findersee/winchController/Electronics/controller.png

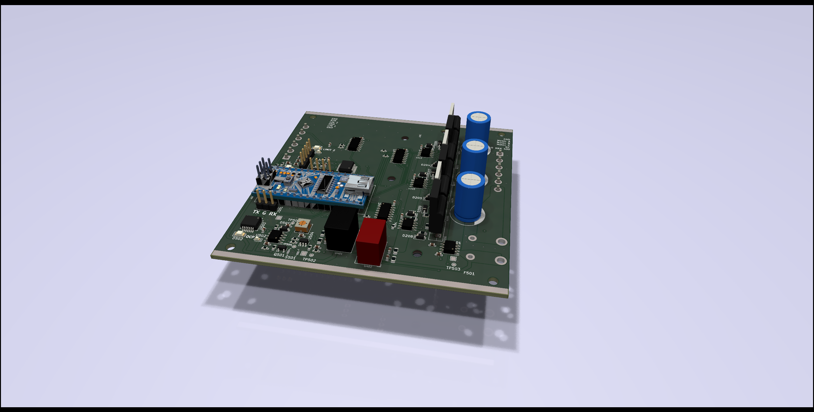
Electronics/controller.png
