findersee/winchController/Electronics/controller.kicad_pcb

## KiCad design Electronics/controller.kicad_pcb (2022-03-30)

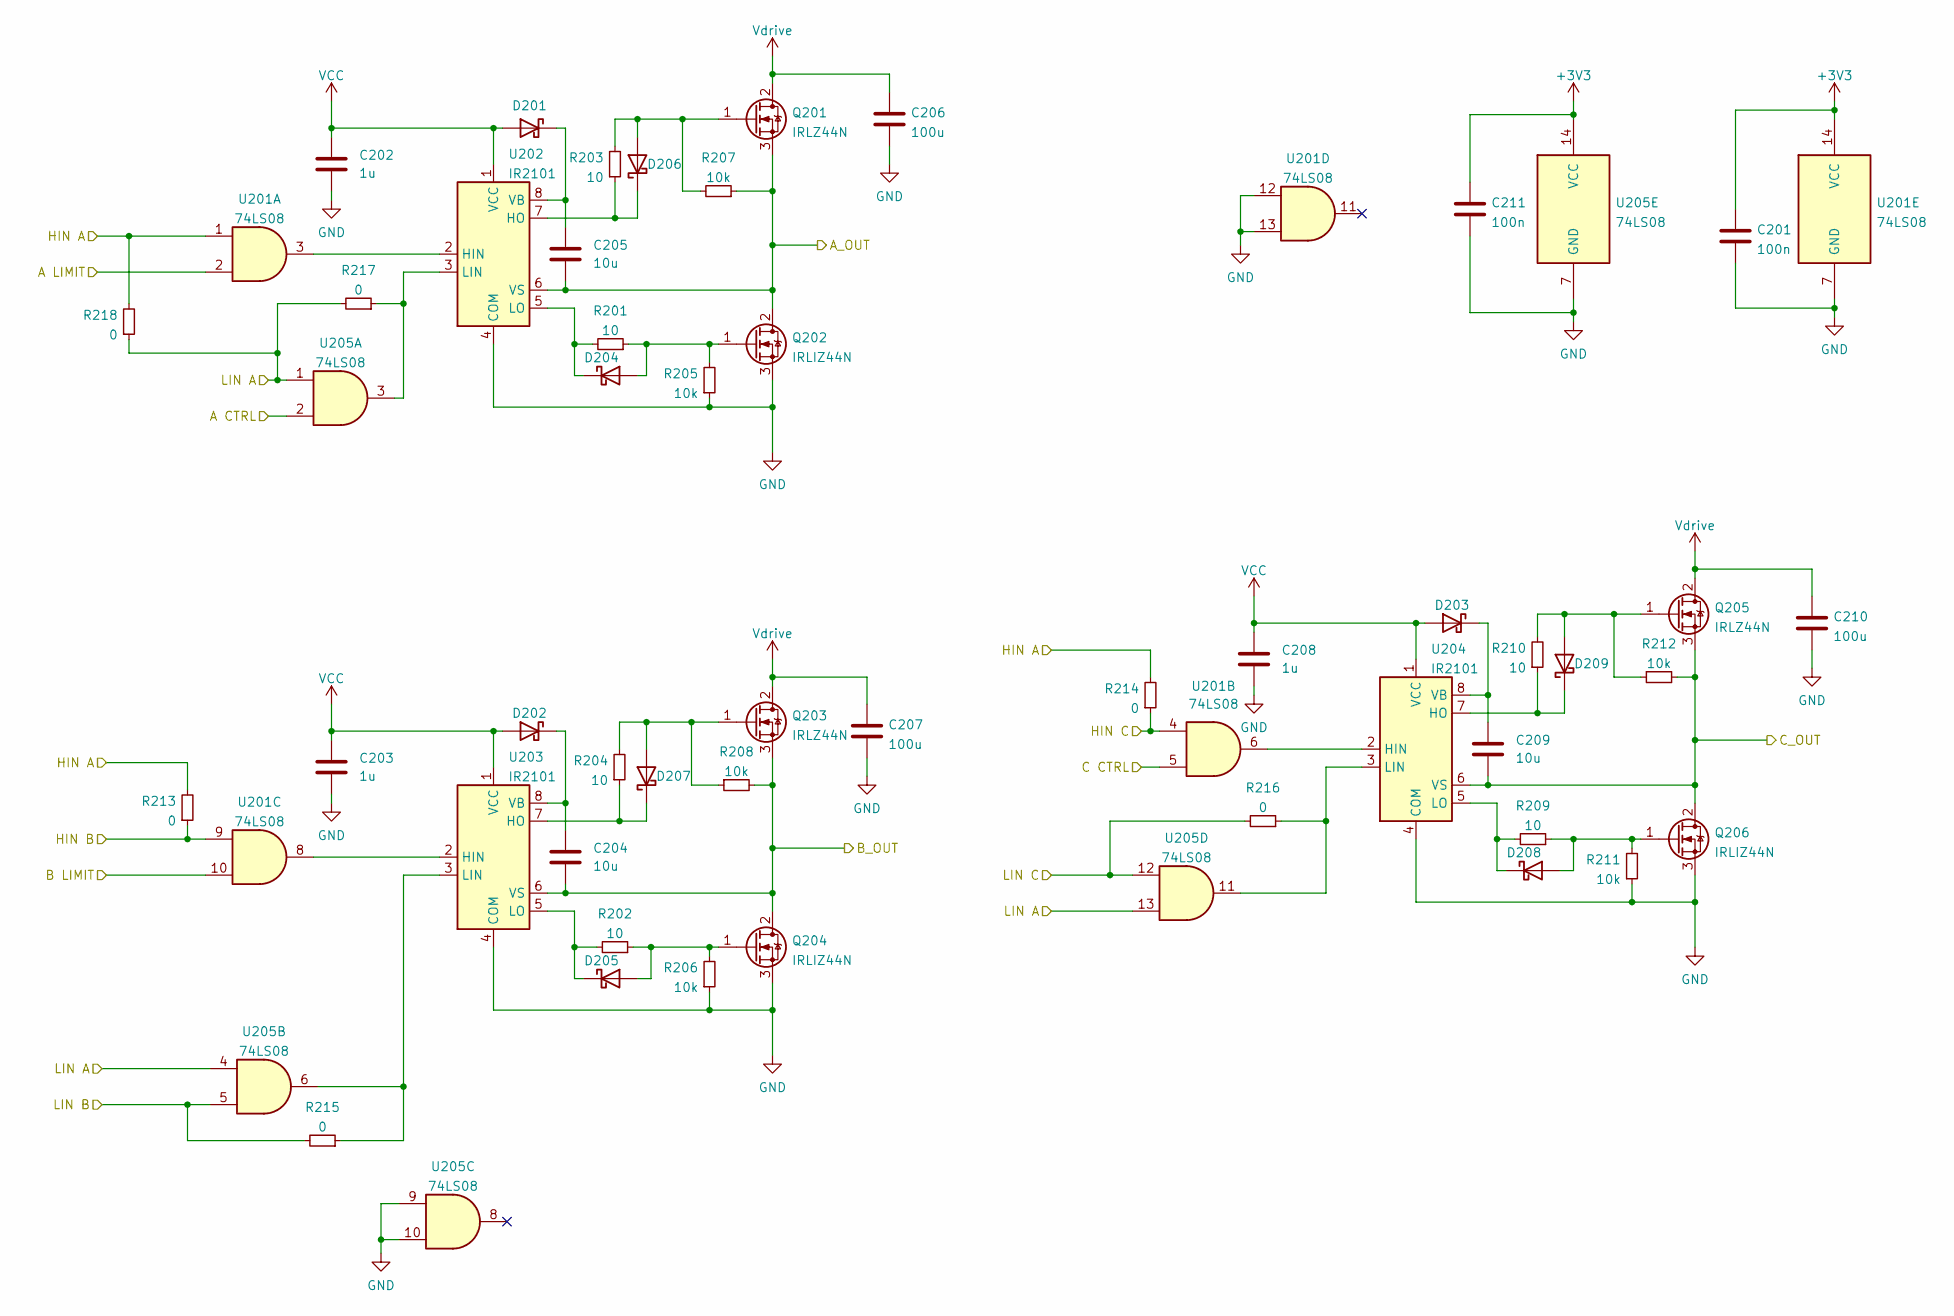
[picture p2: schematic hbridge.kicad_sch, Motor Controller]

Parts:
C201, C211: 100n; C_0603_1608Metric_Pad1.08x0.95mm_HandSolder
C202, C203, C208: 1u; C_0603_1608Metric_Pad1.08x0.95mm_HandSolder
C204, C205, C209: 10u; R_0805_2012Metric_Pad1.20x1.40mm_HandSolder
C206, C207, C210: 100u; CP_Radial_D12.5mm_P3.5-5.0mm
D201, D202, D203, D204, D205, D206, D207, D208, D209: 1N5819; D_SOD-123
Q201, Q203, Q205: IRLZ44N; TO-220-3_Vertical
Q202, Q204, Q206: IRLIZ44N; TO-220F-3_Vertical
R201, R202, R203, R204, R209, R210: 10; R_0805_2012Metric_Pad1.20x1.40mm_HandSolder
R205, R206, R207, R208, R211, R212: 10k; R_0805_2012Metric_Pad1.20x1.40mm_HandSolder
R213, R214, R215, R216, R217, R218: 0; R_0603_1608Metric_Pad0.98x0.95mm_HandSolder
U201, U205: 74LS08; SO-14_3.9x8.65mm_P1.27mm
U202, U203, U204: IR2101; SO-8_3.9x4.9mm_P1.27mm

Connections:
+3V3: C201.1, C211.1, U201.14 (VCC), U205.14 (VCC); also elsewhere on the board
/Connectors/Limit 1: U201.2; also elsewhere on the board
/Connectors/Limit 2: U201.10; also elsewhere on the board
/Connectors/MOTOR C: C209.1, Q205.3 (S), Q206.2 (D), R212.2, U204.6 (VS); also elsewhere on the board
/Connectors/MOTOR NEG: C204.1, Q203.3 (S), Q204.2 (D), R208.2, U203.6 (VS); also elsewhere on the board
/Connectors/MOTOR POS: C205.1, Q201.3 (S), Q202.2 (D), R207.1, U202.6 (VS); also elsewhere on the board
/Hbridge/A CTRL: U205.2; also elsewhere on the board
/Hbridge/C CTRL: U201.5; also elsewhere on the board
/Hbridge/HIN A: R213.2, R214.2, R218.2, U201.1; also elsewhere on the board
/Hbridge/HIN B: R213.1, U201.9; also elsewhere on the board
/Hbridge/HIN C: R214.1, U201.4; also elsewhere on the board
/Hbridge/LIN A: R217.2, R218.1, U205.1, U205.4, U205.13; also elsewhere on the board
/Hbridge/LIN B: R215.2, U205.5; also elsewhere on the board
/Hbridge/LIN C: R216.2, U205.12; also elsewhere on the board
GND: C201.2, C202.1, C203.1, C206.2, C207.2, C208.1, C210.2, C211.2, Q202.3 (S), Q204.3 (S), Q206.3 (S), R205.1, R206.1, R211.1, U201.7 (GND), U201.12, U201.13, U202.4 (COM), U203.4 (COM), U204.4 (COM), U205.7 (GND), U205.9, U205.10; also elsewhere on the board
unnamed: C204.2, D202.1 (K), U203.8 (VB)
unnamed: C205.2, D201.1 (K), U202.8 (VB)
unnamed: C209.2, D203.1 (K), U204.8 (VB)
unnamed: D204.1 (K), R201.2, U202.5 (LO)
unnamed: D204.2 (A), Q202.1 (G), R201.1, R205.2
unnamed: D205.1 (K), R202.2, U203.5 (LO)
unnamed: D205.2 (A), Q204.1 (G), R202.1, R206.2
unnamed: D206.1 (K), R203.1, U202.7 (HO)
unnamed: D206.2 (A), Q201.1 (G), R203.2, R207.2
unnamed: D207.1 (K), R204.1, U203.7 (HO)
unnamed: D207.2 (A), Q203.1 (G), R204.2, R208.1
unnamed: D208.1 (K), R209.2, U204.5 (LO)
unnamed: D208.2 (A), Q206.1 (G), R209.1, R211.2
unnamed: D209.1 (K), R210.1, U204.7 (HO)
unnamed: D209.2 (A), Q205.1 (G), R210.2, R212.1
unnamed: R215.1, U203.3 (LIN), U205.6
unnamed: R216.1, U204.3 (LIN), U205.11
unnamed: R217.1, U202.3 (LIN), U205.3
unnamed: U201.3, U202.2 (HIN)
unnamed: U201.6, U204.2 (HIN)
unnamed: U201.8, U203.2 (HIN)
VCC: C202.2, C203.2, C208.2, D201.2 (A), D202.2 (A), D203.2 (A), U202.1 (VCC), U203.1 (VCC), U204.1 (VCC); also elsewhere on the board
Vdrive: C206.1, C207.1, C210.1, Q201.2 (D), Q203.2 (D), Q205.2 (D); also elsewhere on the board

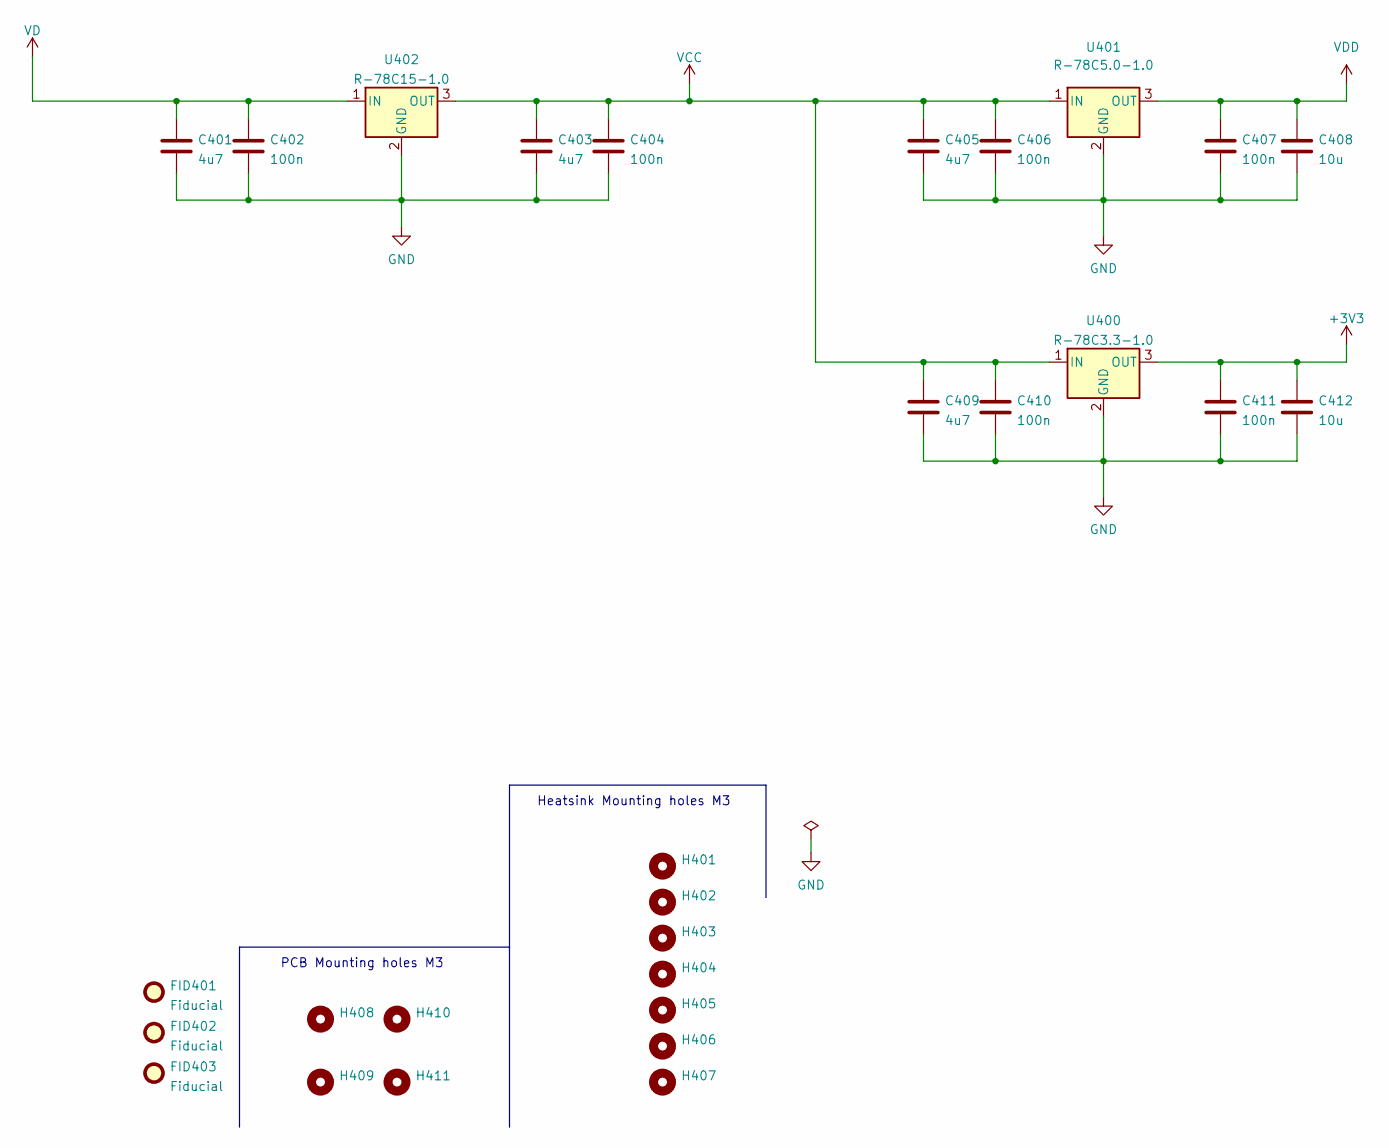
[picture p3: schematic Power.kicad_sch, Motor Controller]

Parts:
C401, C403, C405, C409: 4u7; R_0805_2012Metric_Pad1.20x1.40mm_HandSolder
C402, C404, C406, C407, C410, C411: 100n; C_0603_1608Metric_Pad1.08x0.95mm_HandSolder
C408, C412: 10u; R_0805_2012Metric_Pad1.20x1.40mm_HandSolder
FID401, FID402, FID403: Fiducial; Fiducial_1.5mm_Mask3mm
H401, H402, H403, H404, H405, H406, H407, H408, H409, H410, H411: MountingHole; MountingHole_3.2mm_M3_DIN965
U400: R-78C3.3-1.0; Converter_DCDC_RECOM_R-78E-0.5_THT
U401: R-78C5.0-1.0; Converter_DCDC_RECOM_R-78E-0.5_THT
U402: R-78C15-1.0; Converter_DCDC_RECOM_R-78E-0.5_THT

Connections:
+3V3: C411.1, C412.1, U400.3 (OUT); also elsewhere on the board
GND: C401.2, C402.2, C403.2, C404.2, C405.2, C406.2, C407.2, C408.2, C409.2, C410.2, C411.2, C412.2, U400.2 (GND), U401.2 (GND), U402.2 (GND); also elsewhere on the board
VCC: C403.1, C404.1, C405.1, C406.1, C409.1, C410.1, U400.1 (IN), U401.1 (IN), U402.3 (OUT); also elsewhere on the board
VD: C401.1, C402.1, U402.1 (IN); also elsewhere on the board
VDD: C407.1, C408.1, U401.3 (OUT); also elsewhere on the board

Notes on the sheet:
PCB Mounting holes M3
Heatsink Mounting holes M3

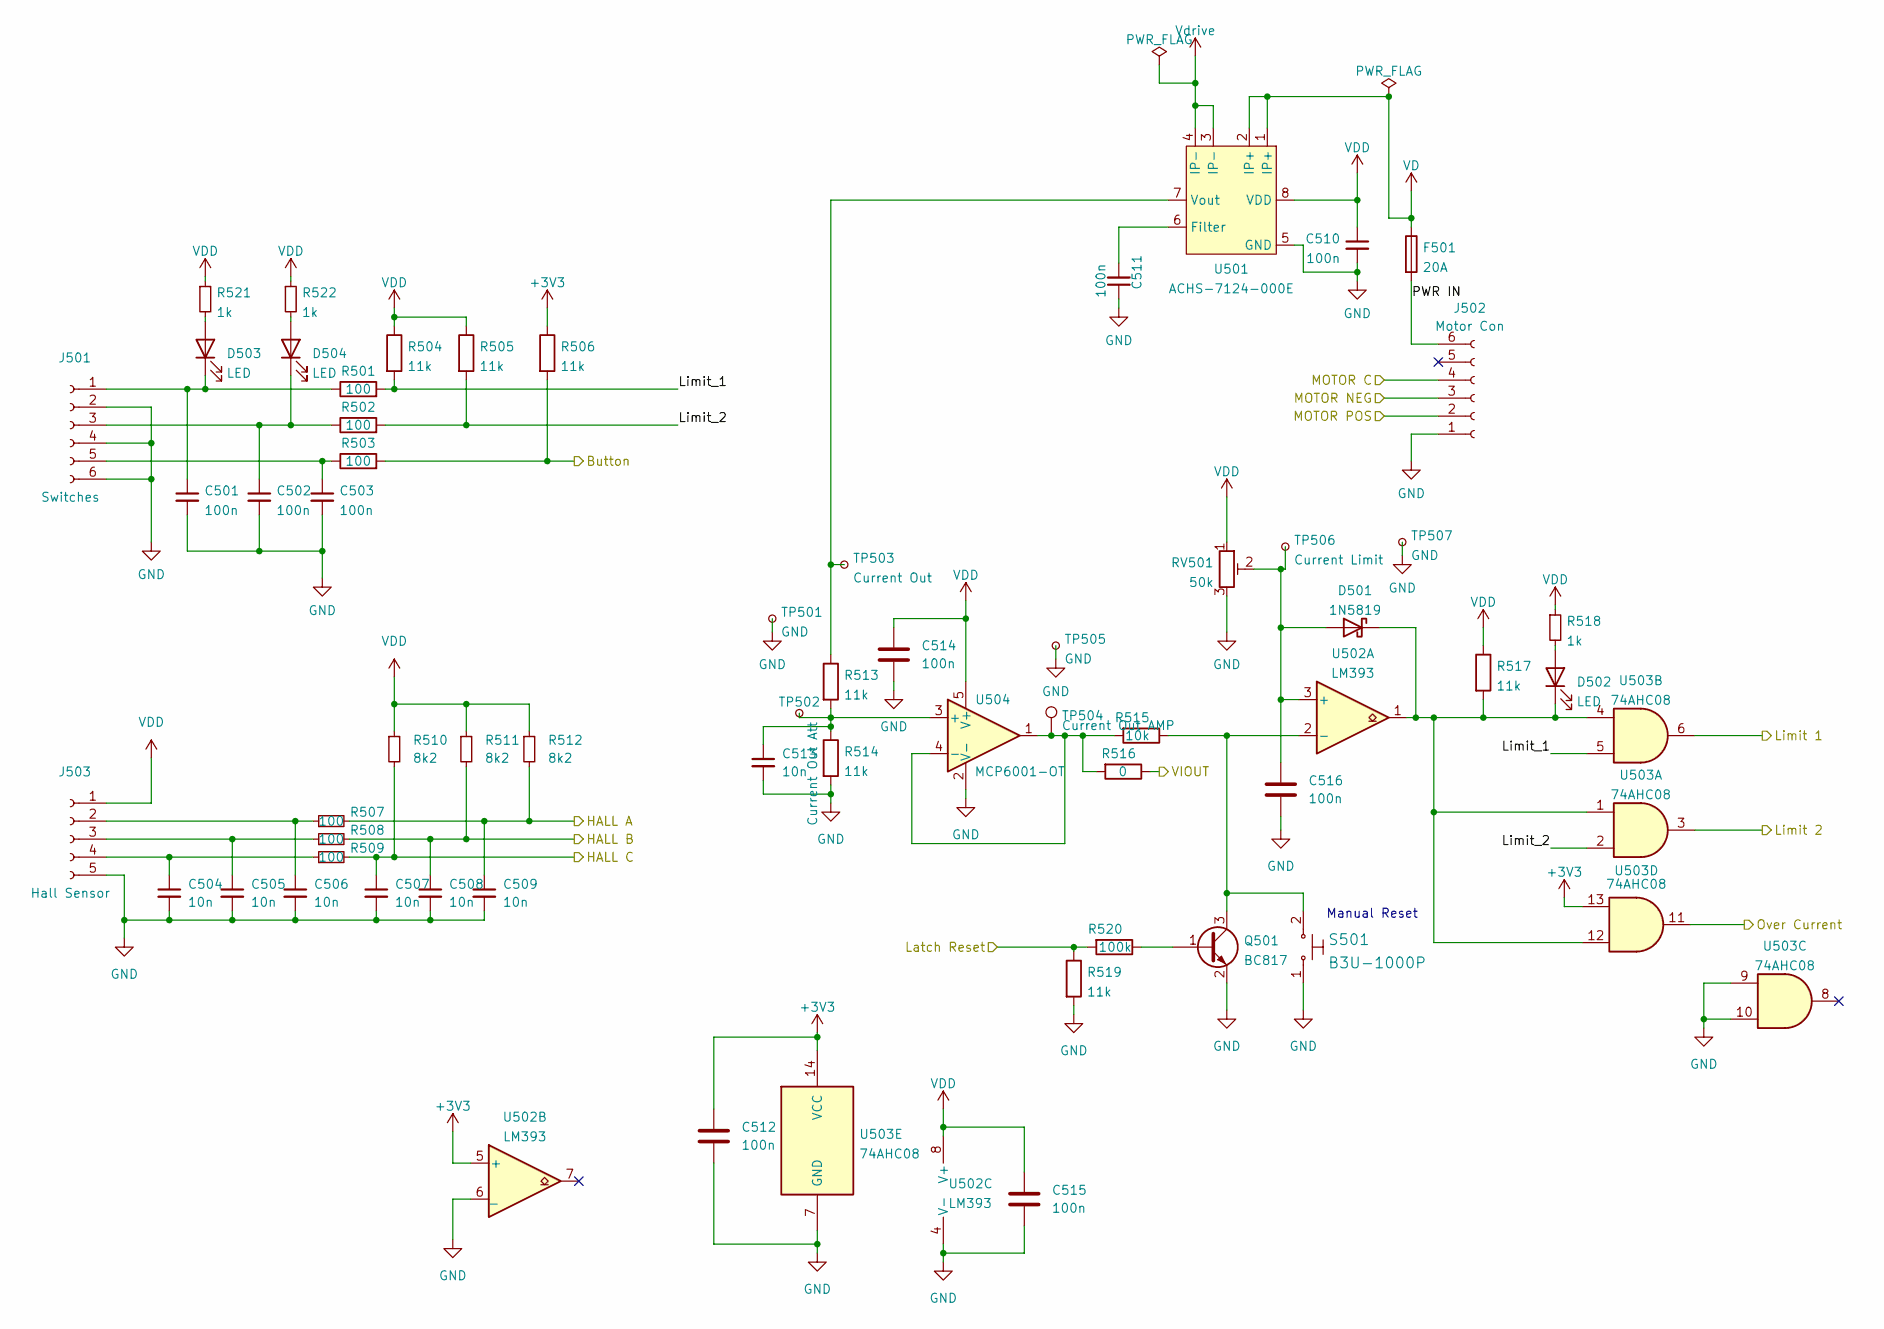
[picture p4: schematic Connectors.kicad_sch, Motor Controller]

Parts:
C501, C502, C503, C510, C511, C512, C514, C515, C516: 100n; C_0603_1608Metric_Pad1.08x0.95mm_HandSolder
C504, C505, C506, C507, C508, C509, C513: 10n; C_0603_1608Metric_Pad1.08x0.95mm_HandSolder
D501: 1N5819; D_SOD-123
D502, D503, D504: LED; LED_1206_3216Metric_Pad1.42x1.75mm_HandSolder
F501: 20A; 3550-2_KEYS
J501: Switches; TerminalBlock_bornier-6_P5.08mm
J502: Motor Con; TerminalBlock_bornier-6_P5.08mm
J503: Hall Sensor; PinHeader_1x05_P2.54mm_Vertical
Q501: BC817; SOT-23
R501, R502, R503, R507, R508, R509: 100; R_0603_1608Metric_Pad0.98x0.95mm_HandSolder
R504, R505, R506, R513, R514, R517, R519: 11k; R_0603_1608Metric_Pad0.98x0.95mm_HandSolder
R510, R511, R512: 8k2; R_0603_1608Metric_Pad0.98x0.95mm_HandSolder
R515: 10k; R_0603_1608Metric_Pad0.98x0.95mm_HandSolder
R516: 0; R_0603_1608Metric_Pad0.98x0.95mm_HandSolder
R518, R521, R522: 1k; LED_0603_1608Metric_Pad1.05x0.95mm_HandSolder
R520: 100k; R_0603_1608Metric_Pad0.98x0.95mm_HandSolder
RV501: 50k; Potentiometer_Vishay_TS53YJ_Vertical
S501: B3U-1000P; Switch_Tactile_SMD_B3U-1000P; MPN B3U-1000P; Digi-Key_PN SW1020CT-ND
TP501, TP505, TP507: GND; TestPoint_Pad_1.5x1.5mm
TP502: Current Out Att; TestPoint_Pad_D1.0mm
TP503: Current Out; TestPoint_Pad_D1.0mm
TP504: Current Out AMP; TestPoint_Pad_D1.0mm
TP506: Current Limit; TestPoint_Pad_D1.0mm
U501: ‎ACHS-7124-000E‎; SO-8_3.9x4.9mm_P1.27mm
U502: LM393; SO-8_3.9x4.9mm_P1.27mm
U503: 74AHC08; SSOP-14_5.3x6.2mm_P0.65mm
U504: MCP6001-OT; SOT-23-5

Connections:
+3V3: C512.2, R506.1, U502.5 (+), U503.13, U503.14 (VCC); also elsewhere on the board
/Connectors/Button: R503.2, R506.2; also elsewhere on the board
/Connectors/HALL A: C509.1, R507.2, R512.2; also elsewhere on the board
/Connectors/HALL B: C508.1, R508.2, R511.2; also elsewhere on the board
/Connectors/HALL C: C507.1, R509.2, R510.2; also elsewhere on the board
/Connectors/Latch Reset: R519.1, R520.2; also elsewhere on the board
/Connectors/Limit 1: U503.6; also elsewhere on the board
/Connectors/Limit 2: U503.3; also elsewhere on the board
/Connectors/Limit_1: R501.2, R504.2, U503.5
/Connectors/Limit_2: R502.2, R505.2, U503.2
/Connectors/MOTOR C: J502.4; also elsewhere on the board
/Connectors/MOTOR NEG: J502.3; also elsewhere on the board
/Connectors/MOTOR POS: J502.2; also elsewhere on the board
/Connectors/Over Current: U503.11; also elsewhere on the board
/Connectors/PWR IN: F501.2, J502.6
/Connectors/VIOUT: R516.1; also elsewhere on the board
GND: C501.2, C502.2, C503.2, C504.2, C505.2, C506.2, C507.2, C508.2, C509.2, C510.2, C511.1, C512.1, C513.2, C514.1, C515.1, C516.1, J501.2, J501.4, J501.6, J502.1, J503.5, Q501.2 (E), R514.2, R519.2, RV501.3, S501.1, TP501.1, TP505.1, TP507.1, U501.5 (GND), U502.4 (V-), U502.6 (_), U503.7 (GND), U503.9, U503.10, U504.2 (V-); also elsewhere on the board
unnamed: C501.1, D503.1 (K), J501.1, R501.1
unnamed: C502.1, D504.1 (K), J501.3, R502.1
unnamed: C503.1, J501.5, R503.1
unnamed: C504.1, J503.4, R509.1
unnamed: C505.1, J503.3, R508.1
unnamed: C506.1, J503.2, R507.1
unnamed: C511.2, U501.6 (Filter)
unnamed: C513.1, R513.2, R514.1, TP502.1, U504.3 (+)
unnamed: C516.2, D501.2 (A), RV501.2, TP506.1, U502.3 (+)
unnamed: D501.1 (K), D502.1 (K), R517.2, U502.1, U503.1, U503.4, U503.12
unnamed: D502.2 (A), R518.2
unnamed: D503.2 (A), R521.2
unnamed: D504.2 (A), R522.2
unnamed: Q501.1 (B), R520.1
unnamed: Q501.3 (C), R515.1, S501.2, U502.2 (-)
unnamed: R513.1, TP503.1, U501.7 (Vout)
unnamed: R515.2, R516.2, TP504.1, U504.1, U504.4 (-)
VD: F501.1, U501.1 (IP+), U501.2 (IP+); also elsewhere on the board
VDD: C510.1, C514.2, C515.2, J503.1, R504.1, R505.1, R510.1, R511.1, R512.1, R517.1, R518.1, R521.1, R522.1, RV501.1, U501.8 (VDD), U502.8 (V+), U504.5 (V+); also elsewhere on the board
Vdrive: U501.3 (IP-), U501.4 (IP-); also elsewhere on the board

Notes on the sheet:
Manual Reset

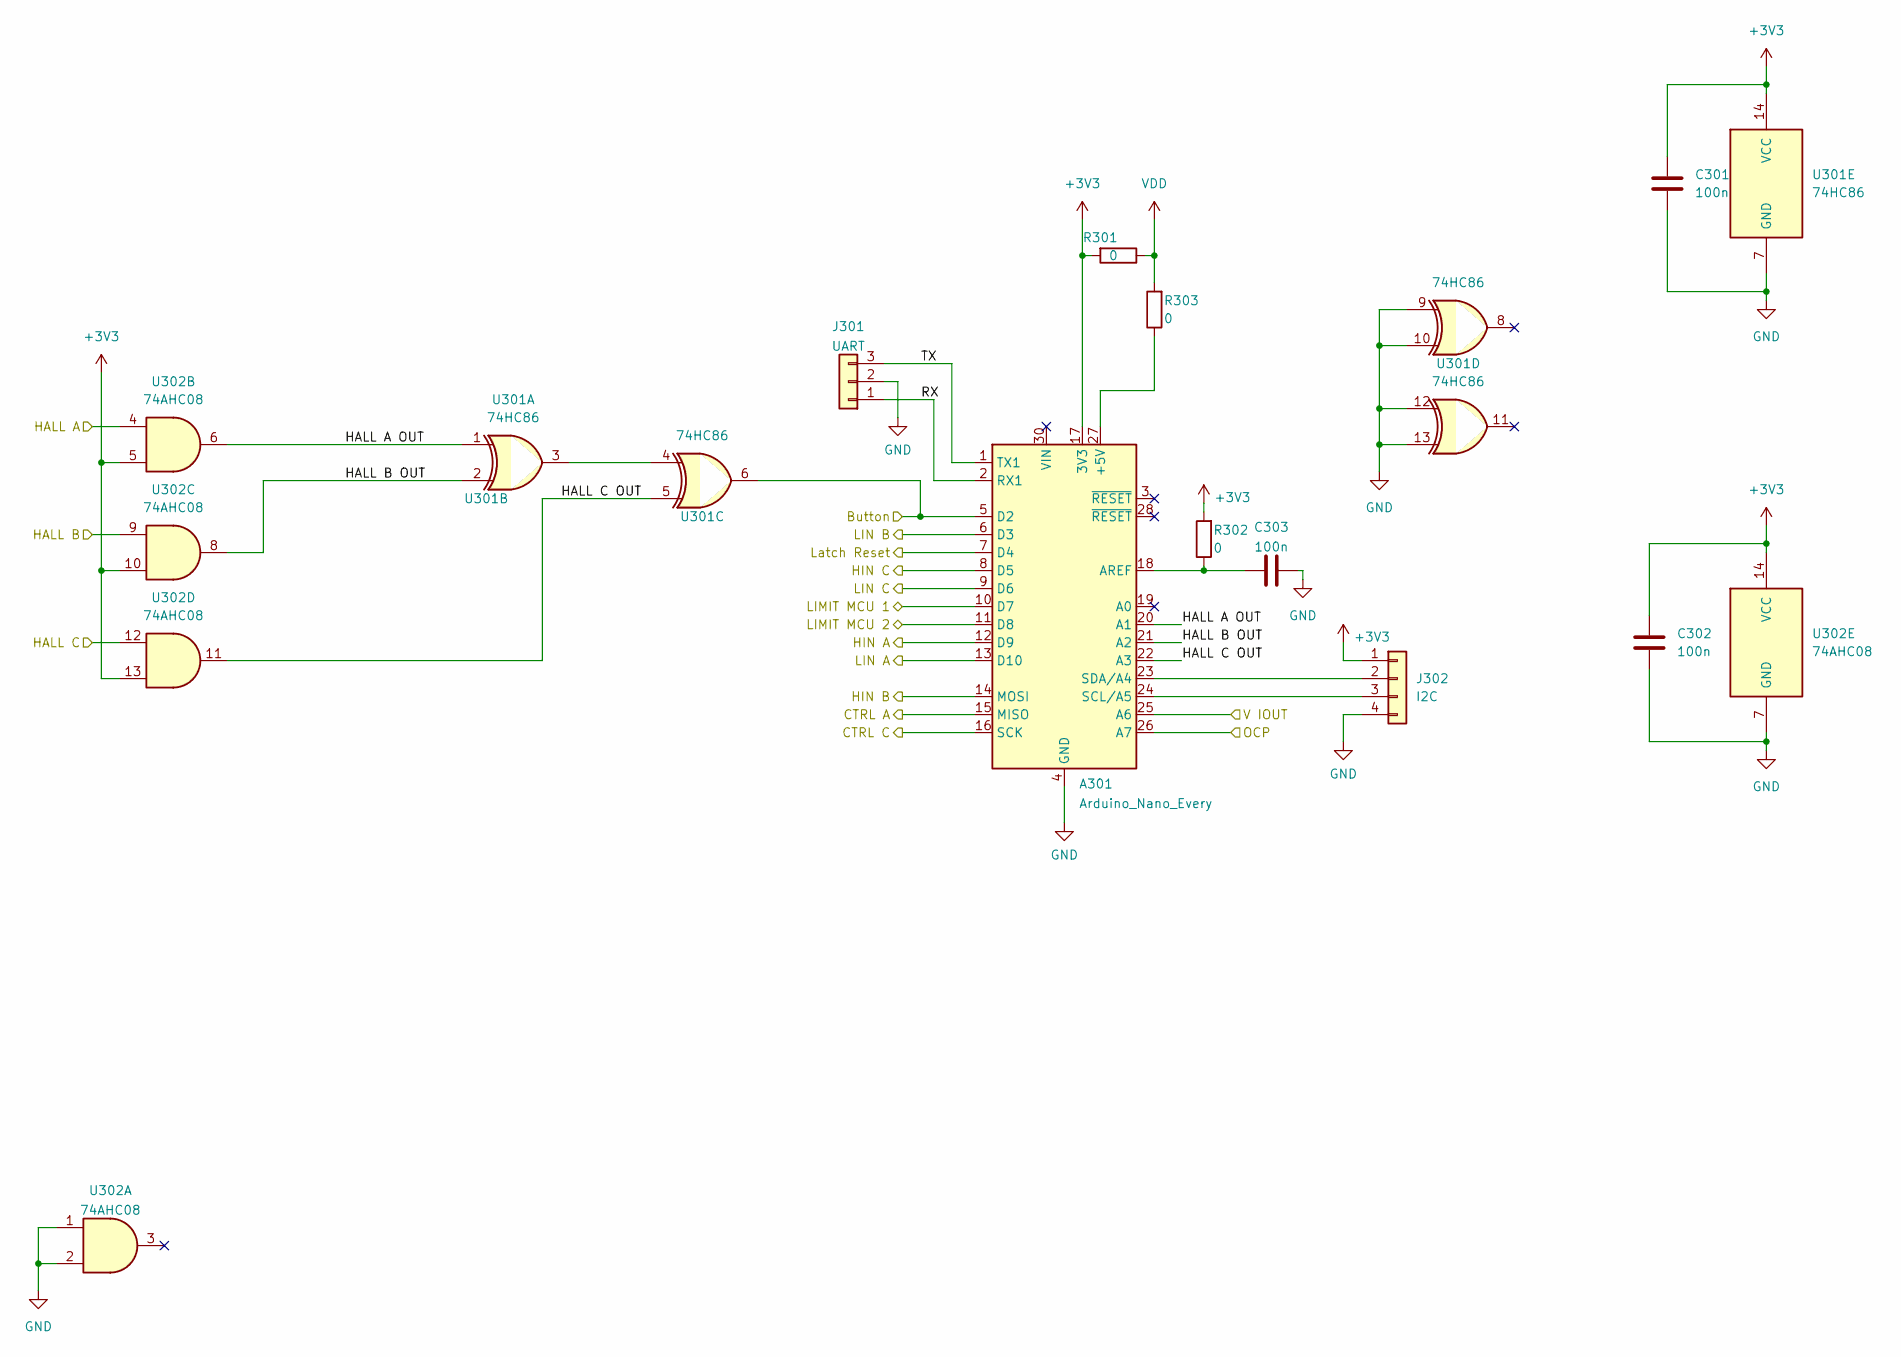
[picture p5: schematic MCU.kicad_sch, Motor Controller]

Parts:
A301: Arduino_Nano_Every; Arduino_Nano
C301, C302, C303: 100n; C_0603_1608Metric_Pad1.08x0.95mm_HandSolder
J301: UART; PinHeader_1x03_P2.54mm_Vertical
J302: I2C; PinHeader_1x04_P2.54mm_Vertical
R301, R302, R303: 0; R_0603_1608Metric_Pad0.98x0.95mm_HandSolder
U301: 74HC86; SO-14_3.9x8.65mm_P1.27mm
U302: 74AHC08; SSOP-14_5.3x6.2mm_P0.65mm

Connections:
+3V3: A301.17 (3V3), C301.2, C302.2, J302.1, R301.2, R302.2, U301.14 (VCC), U302.5, U302.10, U302.13, U302.14 (VCC); also elsewhere on the board
/Connectors/Button: A301.5 (D2), U301.6; also elsewhere on the board
/Connectors/HALL A: U302.4; also elsewhere on the board
/Connectors/HALL B: U302.9; also elsewhere on the board
/Connectors/HALL C: U302.12; also elsewhere on the board
/Connectors/Latch Reset: A301.7 (D4); also elsewhere on the board
/Connectors/Limit 1: A301.10 (D7); also elsewhere on the board
/Connectors/Limit 2: A301.11 (D8); also elsewhere on the board
/Connectors/Over Current: A301.26 (A7); also elsewhere on the board
/Connectors/VIOUT: A301.25 (A6); also elsewhere on the board
/Hbridge/A CTRL: A301.15 (MISO); also elsewhere on the board
/Hbridge/C CTRL: A301.16 (SCK); also elsewhere on the board
/Hbridge/HIN A: A301.12 (D9); also elsewhere on the board
/Hbridge/HIN B: A301.14 (MOSI); also elsewhere on the board
/Hbridge/HIN C: A301.8 (D5); also elsewhere on the board
/Hbridge/LIN A: A301.13 (D10); also elsewhere on the board
/Hbridge/LIN B: A301.6 (D3); also elsewhere on the board
/Hbridge/LIN C: A301.9 (D6); also elsewhere on the board
/MCU/HALL A OUT: A301.20 (A1), U301.1, U302.6
/MCU/HALL B OUT: A301.21 (A2), U301.2, U302.8
/MCU/HALL C OUT: A301.22 (A3), U301.5, U302.11
/MCU/RX: A301.2 (RX1), J301.1
/MCU/TX: A301.1 (TX1), J301.3
GND: A301.4 (GND), A301.29 (GND), C301.1, C302.1, C303.1, J301.2, J302.4, U301.7 (GND), U301.9, U301.10, U301.12, U301.13, U302.1, U302.2, U302.7 (GND); also elsewhere on the board
unnamed: A301.18 (AREF), C303.2, R302.1
unnamed: A301.23 (SDA/A4), J302.2
unnamed: A301.24 (SCL/A5), J302.3
unnamed: A301.27 (+5V), R303.1
unnamed: U301.3, U301.4
VDD: R301.1, R303.2; also elsewhere on the board

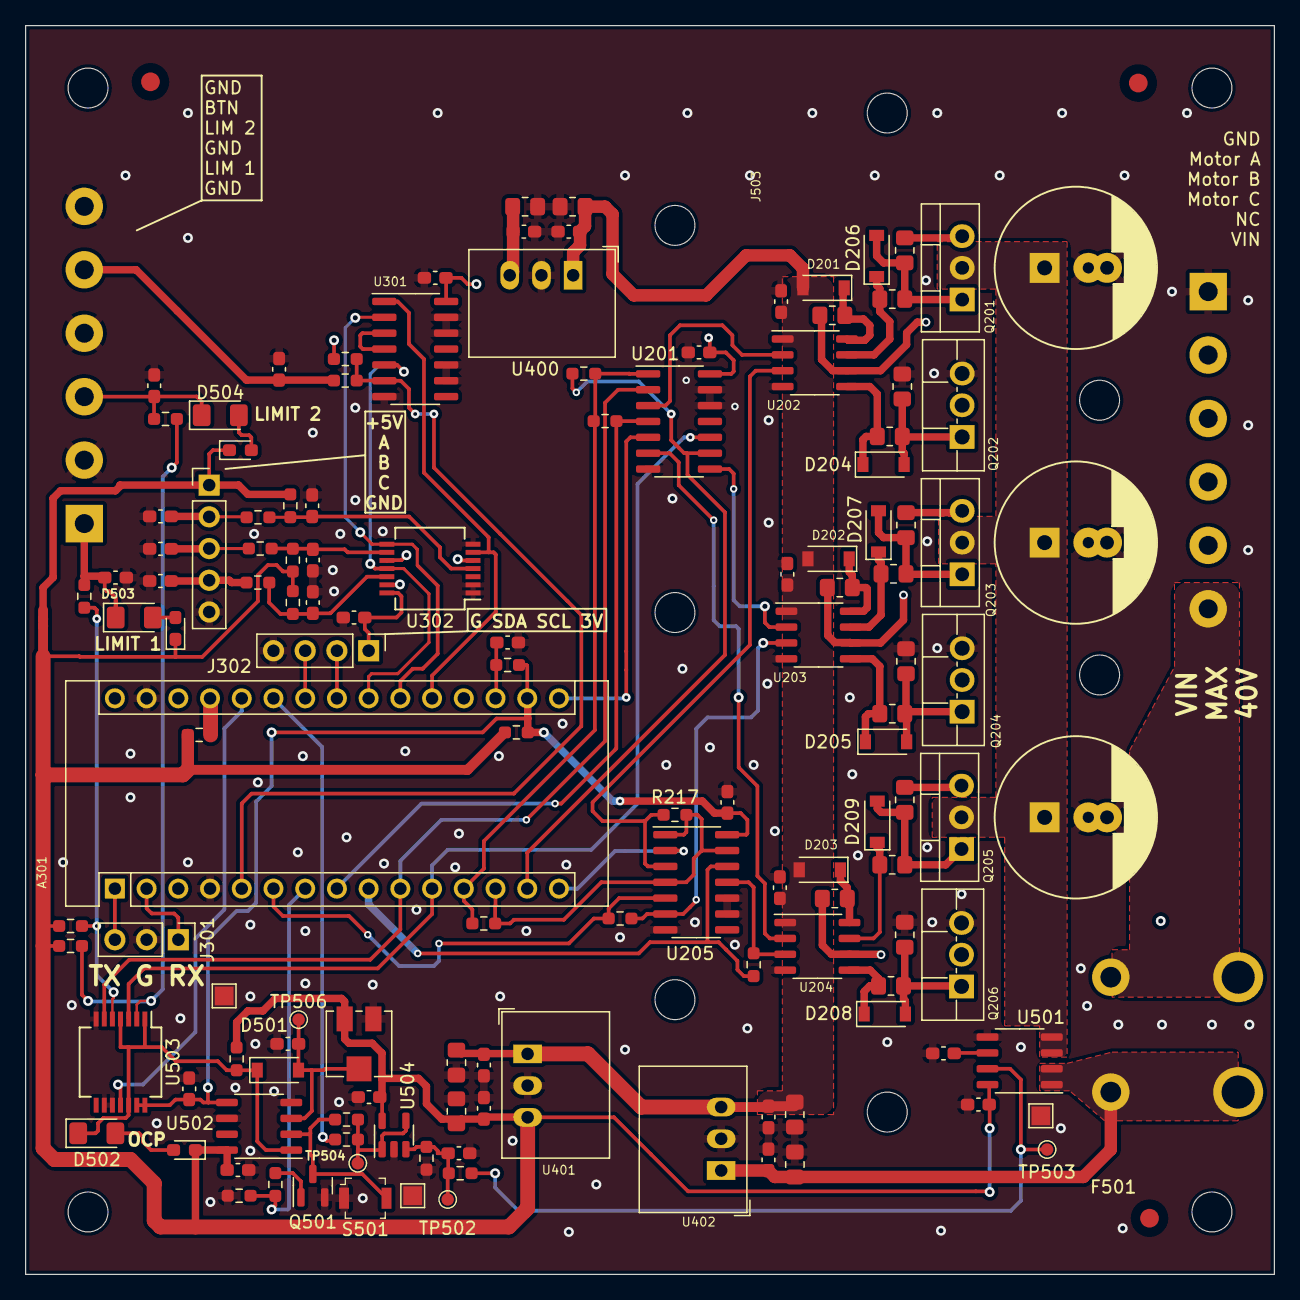
[picture p6: board controller.kicad_pcb from above]

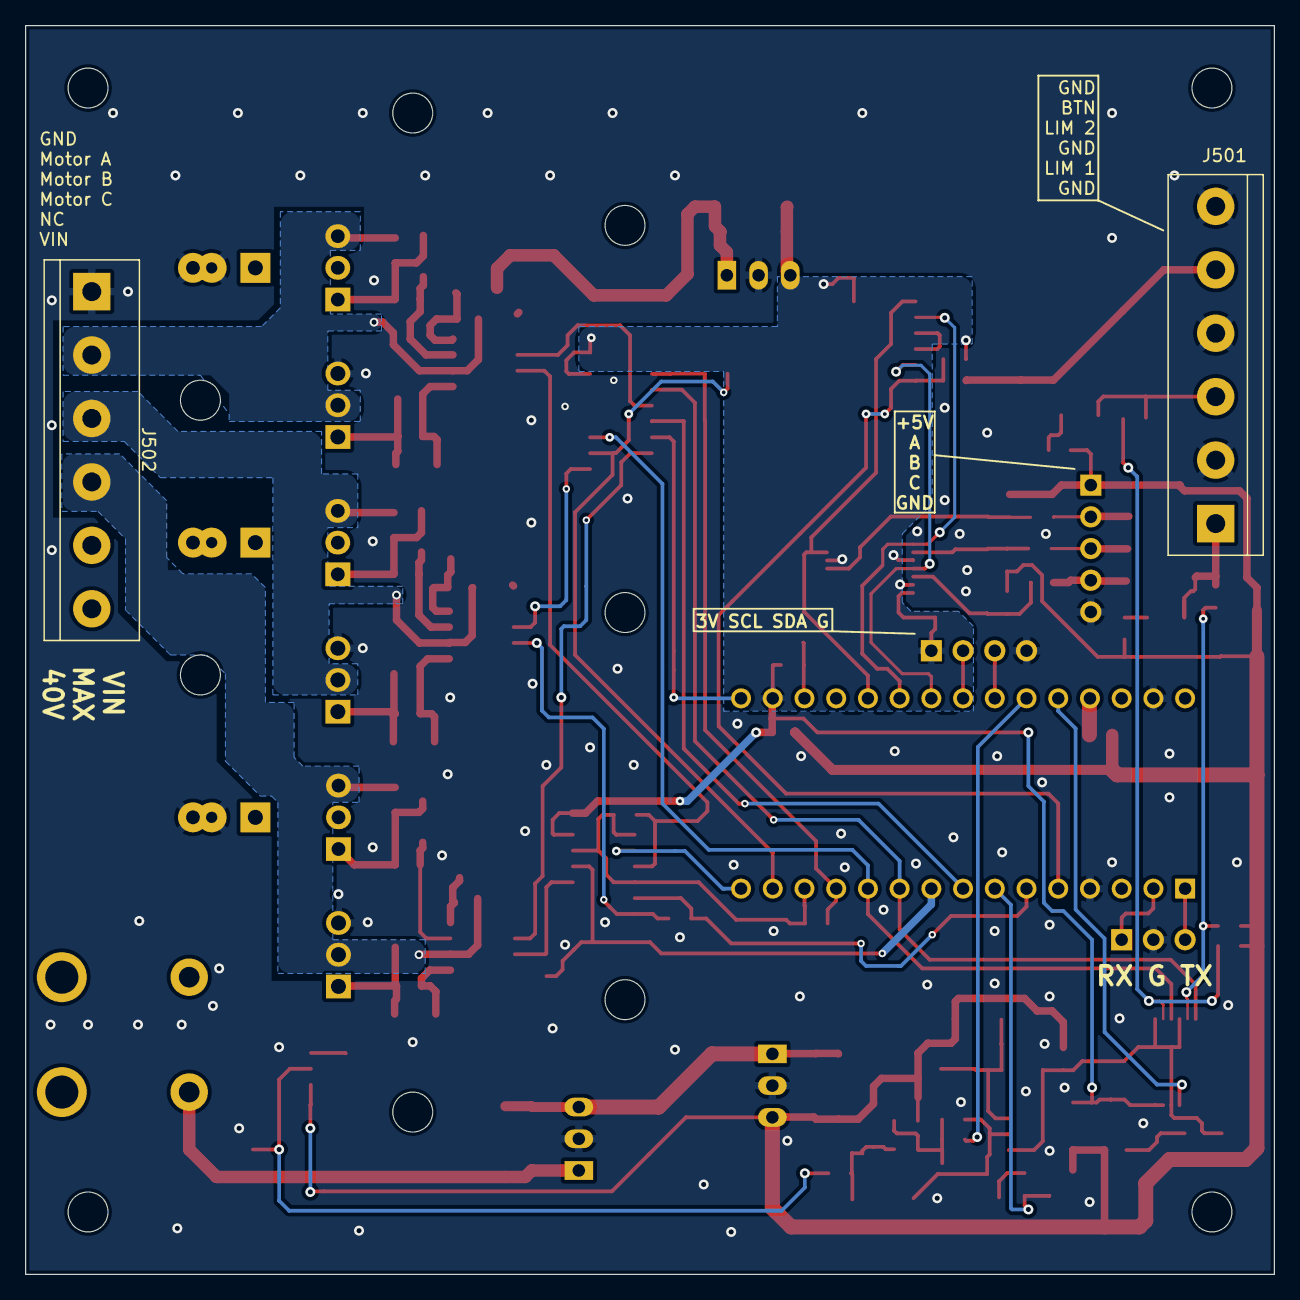
[picture p7: board controller.kicad_pcb from below]

Board: 2 copper layers, 100.0 x 100.0 mm, 149 parts (2 on the bottom side), 77 nets.
