findersee/winchController/Code/Controller/Core/Inc/main.h

#define HI_A_Pin GPIO_PIN_0
#define HI_A_GPIO_Port GPIOF
#define HI_B_Pin GPIO_PIN_1
#define HI_B_GPIO_Port GPIOF
#define HALL_A_Pin GPIO_PIN_1
#define HALL_A_GPIO_Port GPIOA
#define VCP_TX_Pin GPIO_PIN_2
#define VCP_TX_GPIO_Port GPIOA
#define HALL_B_Pin GPIO_PIN_3
#define HALL_B_GPIO_Port GPIOA
#define HALL_C_Pin GPIO_PIN_4
#define HALL_C_GPIO_Port GPIOA
#define LIN_B_Pin GPIO_PIN_0
#define LIN_B_GPIO_Port GPIOB
#define LIN_C_Pin GPIO_PIN_1
#define LIN_C_GPIO_Port GPIOB
#define HIN_A_Pin GPIO_PIN_8
#define HIN_A_GPIO_Port GPIOA
#define LIN_A_Pin GPIO_PIN_11
#define LIN_A_GPIO_Port GPIOA
#define HALL_XOR_Pin GPIO_PIN_12
#define HALL_XOR_GPIO_Port GPIOA
#define SWDIO_Pin GPIO_PIN_13
#define SWDIO_GPIO_Port GPIOA
#define SWCLK_Pin GPIO_PIN_14
#define SWCLK_GPIO_Port GPIOA
#define VCP_RX_Pin GPIO_PIN_15
#define VCP_RX_GPIO_Port GPIOA
#define CTRL_C_Pin GPIO_PIN_3
#define CTRL_C_GPIO_Port GPIOB
#define CTRL_A_Pin GPIO_PIN_4
#define CTRL_A_GPIO_Port GPIOB
