findersee/winchController/(commit log)

2022-01-25 Added code and Kicad template
    [controller.kicad_pcb, controller.kicad_sch]
2022-01-25 Updated code and pcb
    [controller.kicad_pcb, controller.kicad_sch]
2022-02-10 Hbridge addition
    [Connectors.kicad_sch, MCU.kicad_sch, Power.kicad_sch, controller.kicad_sch, hbridge.kicad_sch]
2022-02-11 Added third half bridge for BLDC applications
    [Connectors.kicad_sch, MCU.kicad_sch, Power.kicad_sch, controller.kicad_pcb, controller.kicad_sch, hbridge.kicad_sch]
2022-02-12 Layout update
    [Connectors.kicad_sch, MCU.kicad_sch, Power.kicad_sch, controller.kicad_pcb, controller.kicad_sch, hbridge.kicad_sch]
2022-02-13 Added hall sensor circuitry
    [Connectors.kicad_sch, MCU.kicad_sch, Power.kicad_sch, controller.kicad_pcb, controller.kicad_sch, hbridge.kicad_sch]
2022-02-13 Added Current sensor finalized layout version 0.1
    [Connectors.kicad_sch, MCU.kicad_sch, controller.kicad_pcb, controller.kicad_sch, hbridge.kicad_sch]
2022-02-14 Added current sensor circuitry
    [Connectors.kicad_sch, MCU.kicad_sch, Power.kicad_sch, controller.kicad_pcb, controller.kicad_sch]
2022-02-17 Updated Design
    [Connectors.kicad_sch, MCU.kicad_sch, Power.kicad_sch, controller.kicad_pcb, controller.kicad_sch]
2022-02-18 Chaned 74AHC08 footprint to ssop-14
    [Connectors.kicad_sch, MCU.kicad_sch, controller.kicad_pcb, controller.kicad_sch, hbridge.kicad_sch]
2022-02-18 Layout improvements
    [Connectors.kicad_sch, MCU.kicad_sch, Power.kicad_sch, controller.kicad_pcb, controller.kicad_sch, hbridge.kicad_sch]
2022-02-19 Changed capacitor to multi footprint version. Added parallel diodes to MOSFET gate resistors to improve Turn-OFF time.
    [Connectors.kicad_sch, Power.kicad_sch, controller.kicad_pcb, controller.kicad_sch, hbridge.kicad_sch]
2022-02-20 Manufacturing commit of PCB
    [Connectors.kicad_sch, MCU.kicad_sch, Power.kicad_sch, controller.kicad_pcb, controller.kicad_sch, hbridge.kicad_sch]
2022-03-30 Added STM32 Code for BLDC controller
    [MCU.kicad_sch, Power.kicad_sch, controller.kicad_pcb, controller.kicad_sch]
